lukeTec/tcc_robo_ros2/(commit log)

2025-10-27 Commit inicial do projeto TCC com pacotes de SLAM e Navegação
    [robot_localization.yaml]
2025-11-07 Atualiza Arduino serial; atualiza configs de navegação (EKF/Nav2/BT/RPLidar), adiciona mapas e adiciona pacote de SLAM (Cartographer)
    [robot_localization.yaml]
2025-11-12 12/11 - comunicacao_serial.ino
    current theta = 0
    if (abs(deltaTicksL) > 2000 || abs(deltaTicksR) > 2000) {
    encoder_obj.reset();
    return;
    }
    pwm_L = slew_limit(pwm_L, pwm_L_last, PWM_SLEW_STEP);
    pwm_R = slew_limit(pwm_R, pwm_R_last, PWM_SLEW_STEP);
    [comunicacao_serial.ino]
2025-11-12 Update robot_localization.yaml
    arquivo padrão insersão de IMU
    [robot_localization.yaml]
2025-11-12 12-11 navegacao_sem_container.launch.py
    remoção do static tf ;
    inserção do urdf
